ElectroTechnique/plinky_opensource/hw/plinkyblack_hwmidi_jacks/plinkyblack_hwmidi_jacks.kicad_sch

## KiCad design hw/plinkyblack_hwmidi_jacks/plinkyblack_hwmidi_jacks.kicad_sch (2024-01-15)

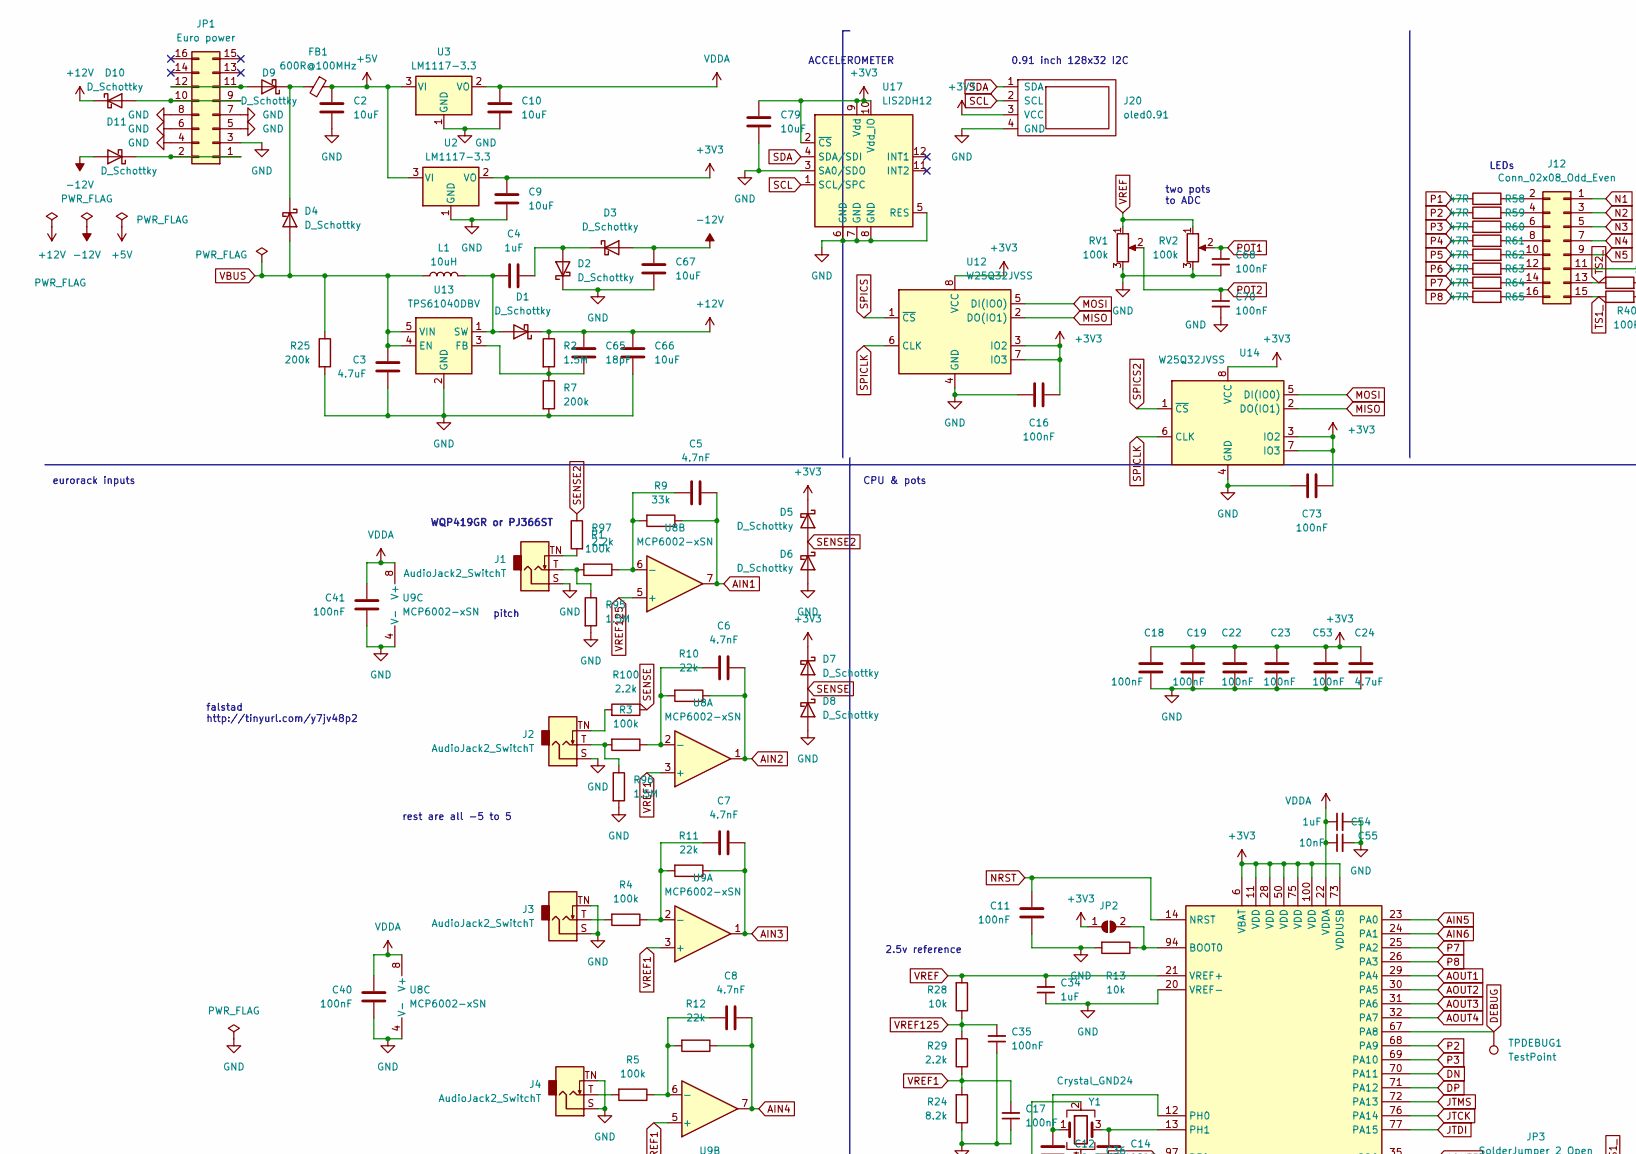
[picture p1: schematic plinkyblack_hwmidi_jacks.kicad_sch, part in row 1, column 1]

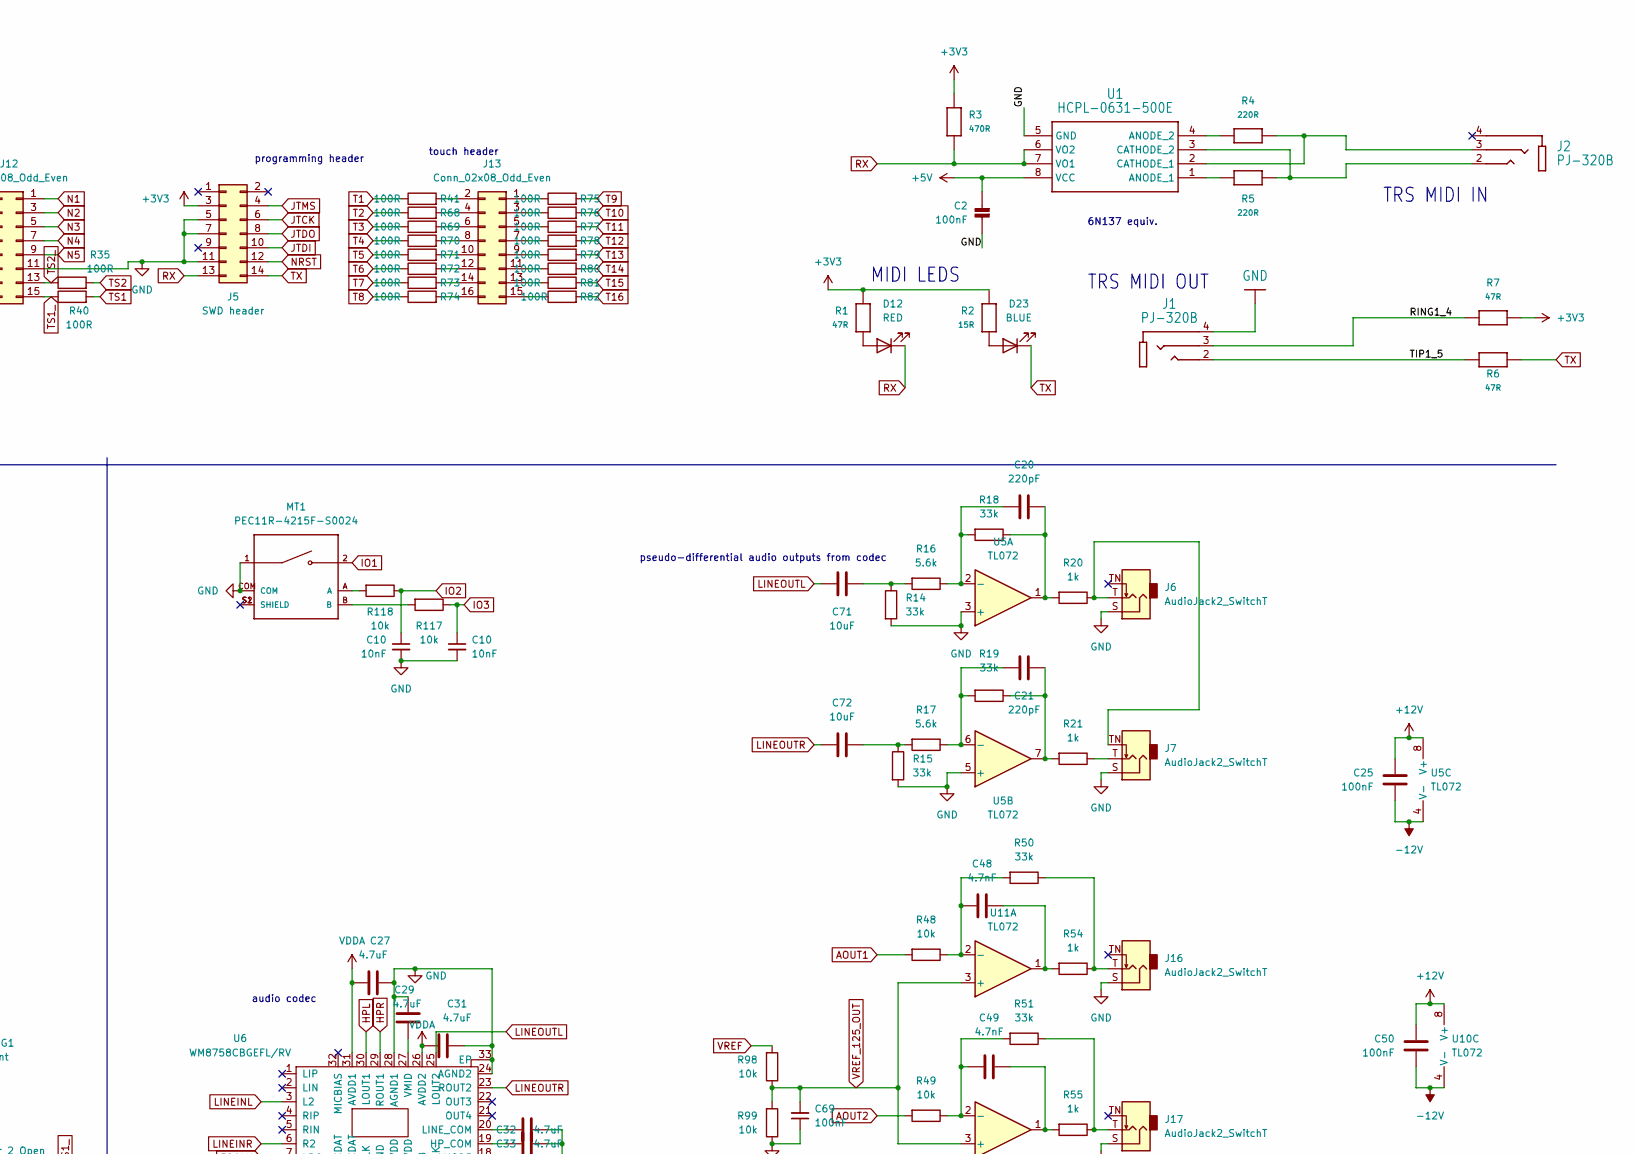
[picture p2: schematic plinkyblack_hwmidi_jacks.kicad_sch, part in row 1, column 2]

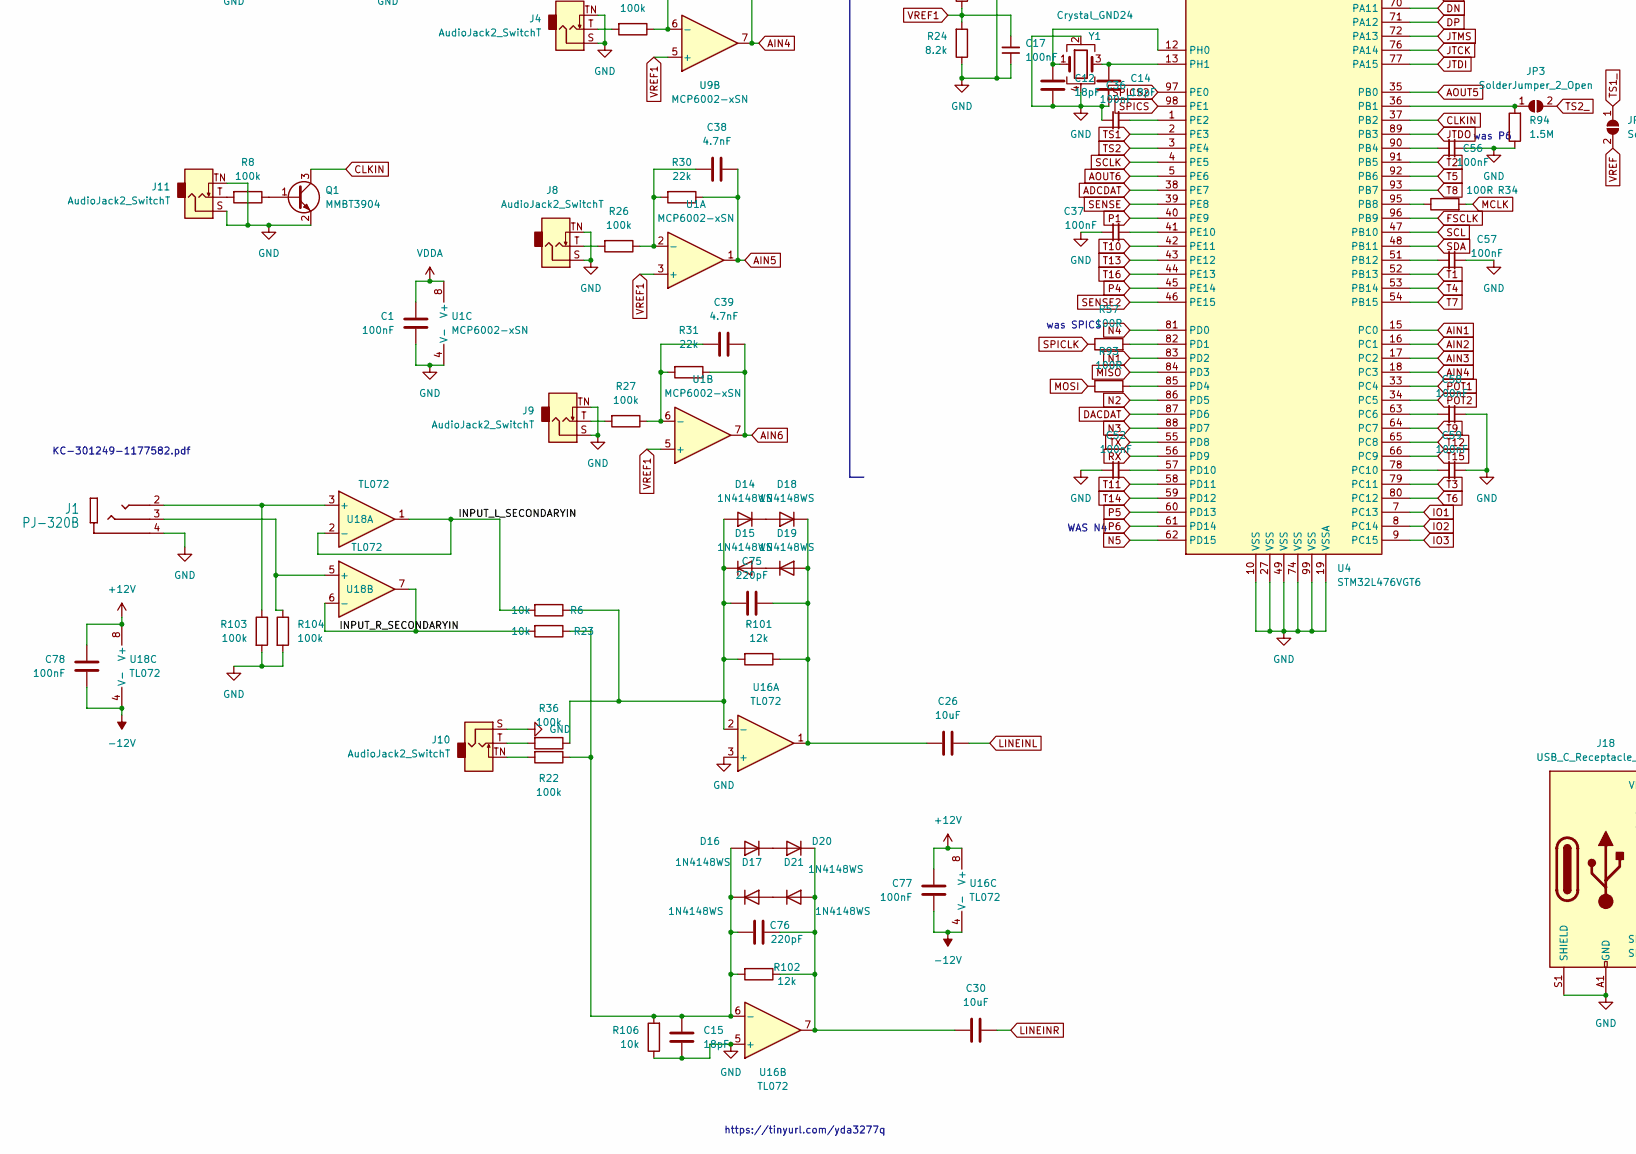
[picture p3: schematic plinkyblack_hwmidi_jacks.kicad_sch, part in row 2, column 1]

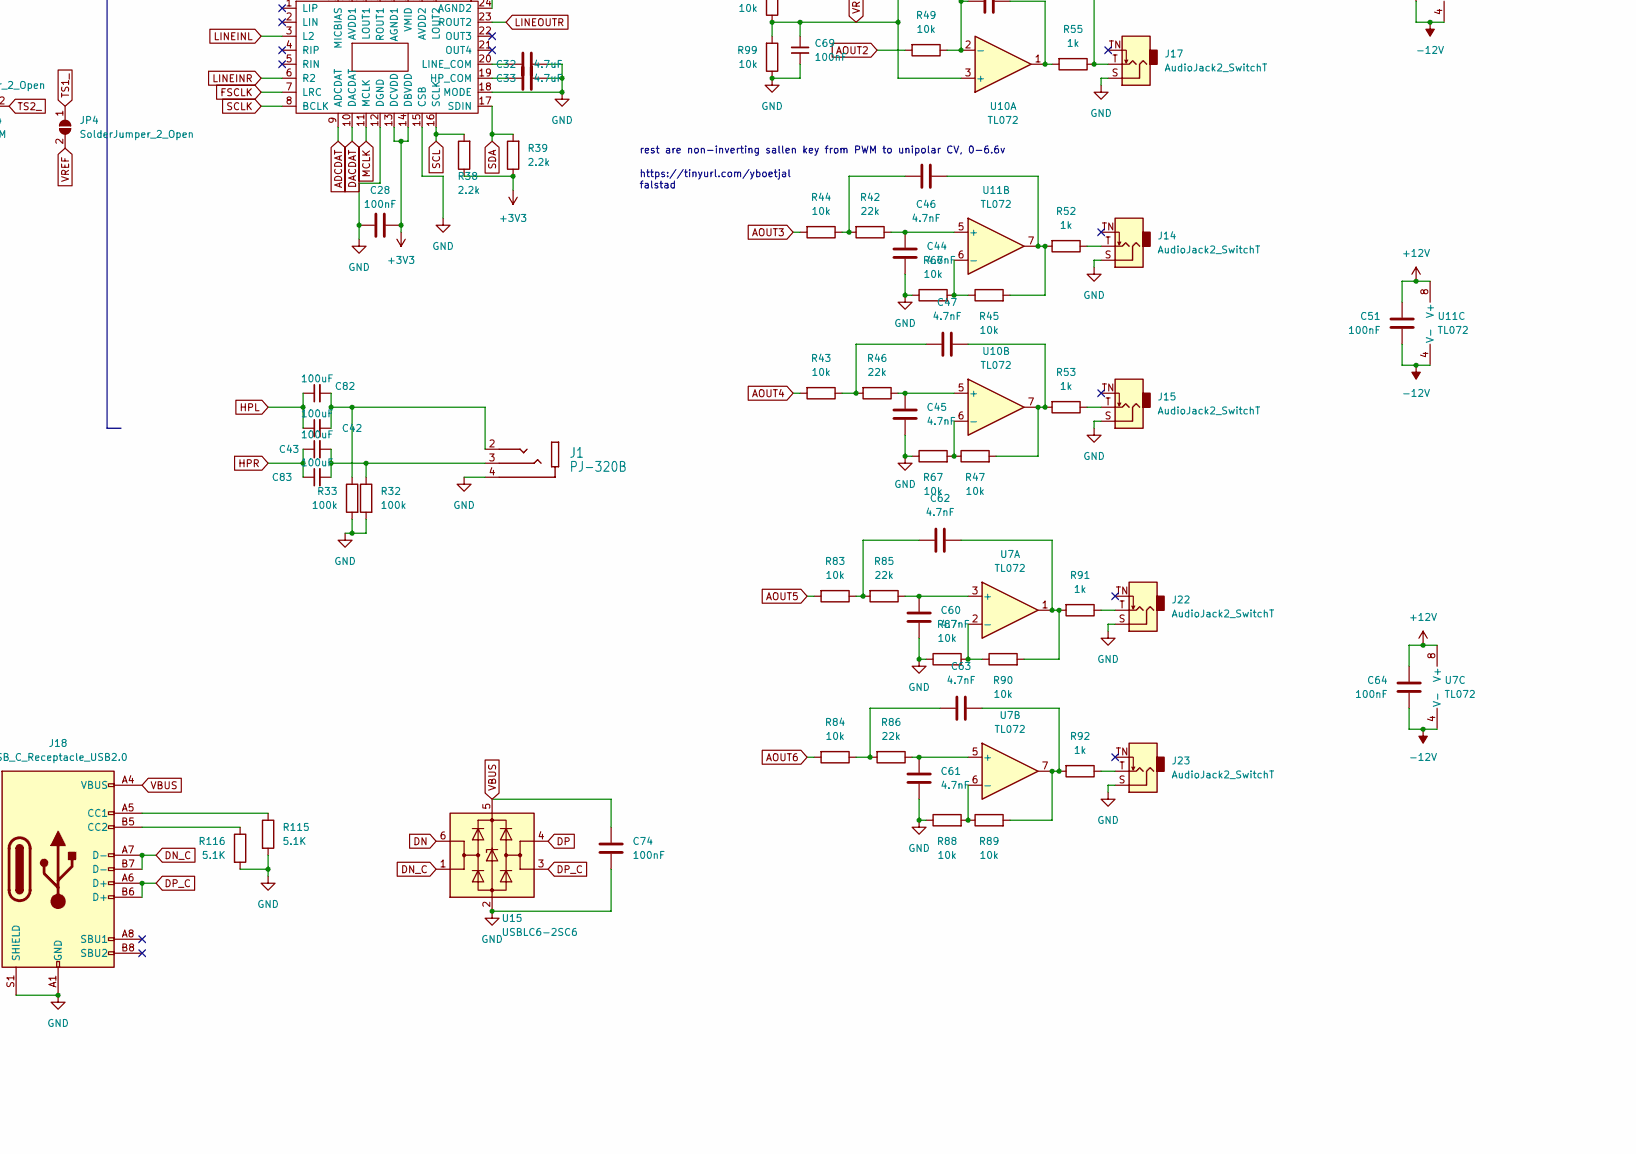
[picture p4: schematic plinkyblack_hwmidi_jacks.kicad_sch, part in row 2, column 2]

Parts:
C1, C11, C16, C17, C18, C19, C22, C23, C25, C28, C35, C36, C37, C40, C41, C50, C51, C52, C53, C56, C57, C58, C59, C64, C68, C69, C70, C73, C74, C77, C78: 100nF; C_0402_1005Metric; LCSC C307331
C2, C9, C10, C26, C30, C66, C67, C71, C72, C79: 10uF; C_0805_2012Metric; LCSC C15850
C3, C24, C27, C29, C31, C32, C33: 4.7uF; C_0603_1608Metric; LCSC C19666
C4, C34, C54: 1uF; C_0402_1005Metric; LCSC C52923
C5, C6, C7, C8, C38, C39, C44, C45, C46, C47, C48, C49, C60, C61, C62, C63: 4.7nF; C_0603_1608Metric; LCSC C53987
C12, C14, C15, C65: 18pF; C_0603_1608Metric; LCSC C1647
C20, C21, C75, C76: 220pF; C_0603_1608Metric; LCSC C1603
C42, C43, C82, C83: 100uF; C_1206_3216Metric; LCSC C15008
C55: 10nF; C_0603_1608Metric; LCSC C57112
D1, D2, D3, D4, D5, D6, D7, D8, D9, D10, D11: D_Schottky; D_SMA; LCSC C8678
D12: RED; LED_0603_1608Metric; LCSC C2286
D14, D15, D16, D17, D18, D19, D20, D21: 1N4148WS; D_SOD-323; LCSC C2128
D23: BLUE; LED_0603_1608Metric; LCSC C72041
FB1: 600R@100MHz; L_0805_2012Metric; LCSC C1017
J1, J2, J3, J4, J6, J7, J8, J9, J10, J11, J14, J15, J16, J17, J22, J23: AudioJack2_SwitchT; thonk_with_3d
J5: SWD header; PinHeader_2x07_P1.27mm_Vertical_SMD
J12, J13: Conn_02x08_Odd_Even; PinSocket_2x08_P2.54mm_Vertical
J18: USB_C_Receptacle_USB2.0; USB_C_Receptacle_HRO_TYPE-C-31-M-12; LCSC C165948
J20: oled0.91; oled091
JP1: Euro power; IDC-Header_2x08_P2.54mm_Horizontal
JP2, JP3, JP4: SolderJumper_2_Open; SolderJumper-2_P1.3mm_Open_Pad1.0x1.5mm
L1: 10uH; L_Murata_LQH55DN_5.7x5.0mm; LCSC C181721
MT1: PEC11R-4215F-S0024; pec11r_encoder
Q1: MMBT3904; SOT-23; LCSC C20526
R1, R3, R4, R5, R8, R26, R27, R32, R33, R103, R104: 100k; R_0402_1005Metric; LCSC C25741
R2, R94, R95, R96: 1.5M; R_0603_1608Metric; LCSC C4172
R6, R58, R59, R60, R61, R62, R63, R64, R65: 47R; R_0603_1608Metric; LCSC C23182
R7, R25: 200k; R_0603_1608Metric; LCSC C25811
R9, R14, R15, R18, R19, R50, R51: 33k; R_0402_1005Metric; LCSC C25779
R10, R11, R12, R30, R31, R42, R46, R85, R86: 22k; R_0402_1005Metric; LCSC C25768
R13, R23, R28, R43, R44, R45, R47, R48, R49, R66, R67, R83, R84, R87, R88, R89, R90, R98, R99, R106: 10k; R_0402_1005Metric; LCSC C25744
R16, R17: 5.6k; R_0603_1608Metric; LCSC C23189
R20, R21, R52, R53, R54, R55, R91, R92: 1k; R_0603_1608Metric; LCSC C21190
R22, R36: 100k; R_0805_2012Metric; LCSC C149504
R24: 8.2k; R_0603_1608Metric; LCSC C25981
R29, R38, R39, R97, R100: 2.2k; R_0603_1608Metric; LCSC C4190
R34, R35, R40, R41, R57, R68, R69, R70, R71, R72, R73, R74, R75, R76, R77, R78, R79, R80, R81, R82, R93: 100R; R_0402_1005Metric; LCSC C25076
R101, R102: 12k; R_0402_1005Metric; LCSC C25752
R115, R116: 5.1K; R_0402_1005Metric; LCSC C25905
R117, R118: 10k; R_0603_1608Metric; LCSC C25804
RV1, RV2: 100k; pot3d
TPDEBUG1: TestPoint; TestPoint_Pad_D1.0mm
U1, U8, U9: MCP6002-xSN; SOIC-8_3.9x4.9mm_P1.27mm; LCSC C7377
U2, U3: LM1117-3.3; SOT-223-3_TabPin2; LCSC C6186
U4: STM32L476VGT6; LQFP-100_14x14mm_P0.5mm; LCSC C83181
U5, U7, U10, U11, U16, U18: TL072; SOIC-8_3.9x4.9mm_P1.27mm; LCSC C6961
U6: WM8758CBGEFL/RV; QFN-32-1EP_5x5mm_P0.5mm_EP3.45x3.45mm; LCSC C323840
U12, U14: W25Q32JVSS; SOIC-8_5.275x5.275mm_P1.27mm; LCSC C97521
U13: TPS61040DBV; SOT-23-5; LCSC C7722
U15: USBLC6-2SC6; SOT-23-6; LCSC C2687116
U17: LIS2DH12; LGA-12_2x2mm_P0.5mm; LCSC C110926
Y1: Crystal_GND24; Crystal_SMD_Abracon_ABM8G-4Pin_3.2x2.5mm; LCSC C13738

Connections:
+3V3: C9.1, C16.1, C18.1, C19.1, C22.1, C23.1, C24.1, C28.2, C53.1, C73.1, C79.1, D5.1 (K), D7.1 (K), J5.3, J20.3 (VCC), JP2.1 (A), R1.2, R2.2, R3.2, R7.2, R38.1, R39.1, U2.2 (VO), U4.6 (VBAT), U4.11 (VDD), U4.28 (VDD), U4.50 (VDD), U4.73 (VDDUSB), U4.75 (VDD), U4.100 (VDD), U6.13 (DCVDD), U6.14 (DBVDD), U12.3 (IO2), U12.7 (IO3), U12.8 (VCC), U14.3 (IO2), U14.7 (IO3), U14.8 (VCC), U17.2 (~CS), U17.9 (Vdd), U17.10 (Vdd_IO)
+5V: C2.1, C2.2, FB1.1, U1.8 (VCC), U2.3 (VI), U3.3 (VI)
+12V: C25.2, C50.2, C51.2, C64.2, C65.2, C66.1, C77.2, C78.2, D1.1 (K), D10.1 (K), R2.1, U5.8 (V+), U7.8 (V+), U10.8 (V+), U11.8 (V+), U16.8 (V+), U18.8 (V+)
-12V: C25.1, C50.1, C51.1, C64.1, C67.1, C77.1, C78.1, D3.2 (A), D11.2 (A), U5.4 (V-), U7.4 (V-), U10.4 (V-), U11.4 (V-), U16.4 (V-), U18.4 (V-)
ADCDAT: U4.38 (PE7), U6.9 (ADCDAT)
AIN1: C5.1, R9.1, U4.15 (PC0), U8.7
AIN2: C6.1, R10.1, U4.16 (PC1), U8.1
AIN3: C7.1, R11.1, U4.17 (PC2), U9.1
AIN4: C8.1, R12.1, U4.18 (PC3), U9.7
AIN5: C38.1, R30.1, U1.1 (ANODE_1), U4.23 (PA0)
AIN6: C39.1, R31.1, U1.7 (VO1), U4.24 (PA1)
AOUT1: R48.2, U4.29 (PA4)
AOUT2: R49.2, U4.30 (PA5)
AOUT3: R44.2, U4.31 (PA6)
AOUT4: R43.2, U4.32 (PA7)
AOUT5: R83.2, U4.35 (PB0)
AOUT6: R84.2, U4.5 (PE6)
CLKIN: Q1.3 (C), U4.37 (PB2)
DACDAT: U4.87 (PD6), U6.10 (DACDAT)
DEBUG: TPDEBUG1.1, U4.67 (PA8)
DN: U4.70 (PA11), U15.6 (I/O1)
DN_C: J18.A7 (D-), J18.B7 (D-), U15.1 (I/O1)
DP: U4.71 (PA12), U15.4 (I/O2)
DP_C: J18.A6 (D+), J18.B6 (D+), U15.3 (I/O2)
FSCLK: U4.96 (PB9), U6.7 (LRC)
GND: C1.1, C2.1, C2.2, C3.2, C9.2, C10.2, C11.2, C12.2, C14.2, C15.1, C16.2, C17.1, C18.2, C19.2, C22.2, C23.2, C24.2, C27.2, C28.1, C29.2, C31.1, C32.2, C33.2, C34.1, C35.1, C36.1, C37.1, C40.1, C41.1, C44.1, C45.1, C52.1, C53.2, C54.2, C55.2, C56.1, C57.1, C58.1, C59.1, C60.1, C61.1, C66.2, C67.2, C68.2, C69.1, C70.2, C73.2, C74.1, C79.2, D2.1 (K), D6.2 (A), D8.2 (A), J1.4 (SLEEVE), J1.S, J2.S, J3.S, J3.TN, J4.S, J4.TN, J5.5, J5.7, J5.11, J6.S, J7.S, J8.S, J8.TN, J9.S, J9.TN, J10.S, J11.S, J11.TN, J12.11, J14.S, J15.S, J16.S, J17.S, J18.A1 (GND), J18.A12 (GND), J18.B1 (GND), J18.B12 (GND), J18.S1 (SHIELD), J20.4 (GND), J22.S, J23.S, JP1.3, JP1.4, JP1.5, JP1.6, JP1.7, JP1.8, MT1.1, MT1.COM, Q1.2 (E), R7.2, R13.2, R14.2, R15.2, R24.1, R25.2, R32.2, R33.2, R66.1, R67.1, R87.1, R88.1, R94.1, R95.2, R96.2, R99.1, R103.2, R104.2, R106.1, R115.2, R116.2, RV1.3, RV2.3, U1.4 (ANODE_2), U1.5 (GND), U2.1 (GND), U3.1 (GND), U4.10 (VSS), U4.19 (VSSA), U4.20 (VREF-), U4.27 (VSS), U4.49 (VSS), U4.74 (VSS), U4.99 (VSS), U5.3 (+), U5.5 (+), U6.12 (DGND), U6.15 (CSB), U6.18 (MODE), U6.24 (AGND2), U6.28 (AGND1), U6.33 (EP), U8.4 (V-), U9.4 (V-), U12.4 (GND), U13.2 (GND), U14.4 (GND), U15.2 (GND), U16.3 (+), U16.5 (+), U17.3 (SA0/SDO), U17.5 (RES), U17.6 (GND), U17.7 (GND), U17.8 (GND), Y1.2, Y1.4
HPL: C42.1, C82.1, U6.30 (LOUT1)
HPR: C43.1, C83.1, U6.29 (ROUT1)
INPUT_L_SECONDARYIN: R6.2, U18.1, U18.2 (-)
INPUT_R_SECONDARYIN: R23.2, U18.6 (-), U18.7
IO1: MT1.2, U4.7 (PC13)
IO2: C10.1, R118.1, U4.8 (PC14)
IO3: C10.1, R117.1, U4.9 (PC15)
JTCK: J5.6, U4.76 (PA14)
JTDI: J5.10, U4.77 (PA15)
JTDO: J5.8, U4.89 (PB3)
JTMS: J5.4, U4.72 (PA13)
LINEINL: C26.1, U6.3 (L2)
LINEINR: C30.1, U6.6 (R2)
LINEOUTL: C71.2, U6.25 (LOUT2)
LINEOUTR: C72.2, U6.23 (ROUT2)
MCLK: R34.2, U6.11 (MCLK)
MISO: U4.84 (PD3), U12.2 (DO(IO1)), U14.2 (DO(IO1))
MOSI: R93.1, U12.5 (DI(IO0)), U14.5 (DI(IO0))
N1: J12.1, U4.83 (PD2)
N2: J12.3, U4.86 (PD5)
N3: J12.5, U4.88 (PD7)
N4: J12.7, U4.81 (PD0)
N5: J12.9, U4.62 (PD15)
NRST: C11.1, J5.12, U4.14 (NRST)
unnamed: C4.1, D2.2 (A), D3.1 (K)
unnamed: C4.2, D1.2 (A), L1.2, U13.1 (SW)
unnamed: C5.2, R1.1, R9.2, U8.6 (-)
unnamed: C6.2, R3.1, R10.2, U8.2 (-)
unnamed: C7.2, R4.1, R11.2, U9.2 (-)
unnamed: C8.2, R5.1, R12.2, U9.6 (-)
unnamed: C12.1, U4.12 (PH0), Y1.1
unnamed: C14.1, U4.13 (PH1), Y1.3
unnamed: C15.2, C76.1, D16.2 (A), D17.1 (K), R22.1, R23.1, R102.2, R106.2, U16.6 (-)
unnamed: C20.1, R18.1, R20.2, U5.1
unnamed: C20.2, R16.1, R18.2, U5.2 (-)
unnamed: C21.1, R19.1, R21.2, U5.7
unnamed: C21.2, R17.1, R19.2, U5.6 (-)
unnamed: C26.2, C75.2, D18.1 (K), D19.2 (A), R101.1, U16.1
unnamed: C29.1, U6.27 (VMID)
unnamed: C30.2, C76.2, D20.1 (K), D21.2 (A), R102.1, U16.7
unnamed: C32.1, U6.20 (LINE_COM)
unnamed: C33.1, U6.19 (HP_COM)
unnamed: C36.2, U4.1 (PE2)
unnamed: C37.2, U4.41 (PE10)
unnamed: C38.2, R26.1, R30.2, U1.2 (CATHODE_1)
unnamed: C39.2, R27.1, R31.2, U1.6 (VO2)
unnamed: C42.2, C82.2, J1.2 (TIP), R33.1
unnamed: C43.2, C83.2, J1.3 (RING), R32.1
unnamed: C44.2, R42.1, U11.5 (+)
unnamed: C45.2, R46.1, U10.5 (+)
unnamed: C46.1, R42.2, R44.1
unnamed: C46.2, R45.2, R52.2, U11.7
unnamed: C47.1, R43.1, R46.2
unnamed: C47.2, R47.2, R53.2, U10.7
unnamed: C48.1, R54.2, U11.1
unnamed: C48.2, R48.1, R50.2, U11.2 (-)
unnamed: C49.1, R55.2, U10.1
unnamed: C49.2, R49.1, R51.2, U10.2 (-)
unnamed: C52.2, U4.57 (PD10)
unnamed: C56.2, U4.90 (PB4)
unnamed: C57.2, U4.51 (PB12)
unnamed: C58.2, U4.63 (PC6)
unnamed: C59.2, U4.78 (PC10)
unnamed: C60.2, R85.1, U7.3 (+)
unnamed: C61.2, R86.1, U7.5 (+)
unnamed: C62.1, R83.1, R85.2
unnamed: C62.2, R90.2, R91.2, U7.1
unnamed: C63.1, R84.1, R86.2
unnamed: C63.2, R89.2, R92.2, U7.7
unnamed: C65.1, R2.2, R7.1, U13.3 (FB)
unnamed: C71.1, R14.1, R16.2
unnamed: C72.1, R15.1, R17.2
unnamed: C75.1, D14.2 (A), D15.1 (K), R6.1, R36.1, R101.2, U16.2 (-)
unnamed: D4.1 (K), D9.1 (K), FB1.2
unnamed: D9.2 (A), JP1.11, JP1.12
unnamed: D10.2 (A), JP1.9, JP1.10
unnamed: D11.1 (K), JP1.1, JP1.2
unnamed: D12.2 (A), R1.1
unnamed: D14.1 (K), D18.2 (A)
unnamed: D15.2 (A), D19.1 (K)
unnamed: D16.1 (K), D20.2 (A)
unnamed: D17.2 (A), D21.1 (K)
unnamed: D23.2 (A), R2.1
unnamed: J1.2 (TIP), R103.1, U18.3 (+)
unnamed: J1.3 (RING), R104.1, U18.5 (+)
unnamed: J1.T, R1.2, R95.1
unnamed: J1.TN, R97.2
unnamed: J2.2 (TIP), R5.1, U1.3 (CATHODE_2)
unnamed: J2.3 (RING), R4.1, U1.2 (CATHODE_1)
unnamed: J2.T, R3.2, R96.1
unnamed: J2.TN, R100.2
unnamed: J3.T, R4.2
unnamed: J4.T, R5.2
unnamed: J6.T, J7.TN, R20.1
unnamed: J7.T, R21.1
unnamed: J8.T, R26.2
unnamed: J9.T, R27.2
unnamed: J10.T, R36.2
unnamed: J10.TN, R22.2
unnamed: J11.T, R8.2
unnamed: J12.2, R58.2
unnamed: J12.4, R59.2
unnamed: J12.6, R60.2
unnamed: J12.8, R61.2
unnamed: J12.10, R62.2
unnamed: J12.12, R63.2
unnamed: J12.14, R64.2
unnamed: J12.16, R65.2
unnamed: J13.1, R75.1
unnamed: J13.2, R41.2
unnamed: J13.3, R76.1
unnamed: J13.4, R68.2
unnamed: J13.5, R77.1
unnamed: J13.6, R69.2
unnamed: J13.7, R78.1
unnamed: J13.8, R70.2
unnamed: J13.9, R79.1
unnamed: J13.10, R71.2
unnamed: J13.11, R80.1
unnamed: J13.12, R72.2
unnamed: J13.13, R81.1
unnamed: J13.14, R73.2
unnamed: J13.15, R82.1
unnamed: J13.16, R74.2
unnamed: J14.T, R52.1
unnamed: J15.T, R53.1
unnamed: J16.T, R50.1, R54.1
unnamed: J17.T, R51.1, R55.1
unnamed: J18.A5 (CC1), R115.1
unnamed: J18.B5 (CC2), R116.1
unnamed: J22.T, R91.1
unnamed: J23.T, R92.1
unnamed: JP2.2 (B), R13.1, U4.94 (BOOT0)
unnamed: JP3.1 (A), R94.2, U4.36 (PB1)
unnamed: MT1.A, R118.2
unnamed: MT1.B, R117.2
unnamed: MT1.S1 (SHIELD), MT1.S2 (SHIELD)
unnamed: Q1.1 (B), R8.1
unnamed: R4.2, U1.4 (ANODE_2)
unnamed: R5.2, U1.1 (ANODE_1)
unnamed: R34.1, U4.95 (PB8)
unnamed: R45.1, R66.2, U11.6 (-)
unnamed: R47.1, R67.2, U10.6 (-)
unnamed: R57.2, U4.82 (PD1)
unnamed: R87.2, R90.1, U7.2 (-)
unnamed: R88.2, R89.1, U7.6 (-)
unnamed: R93.2, U4.85 (PD4)
P1: R58.1, U4.40 (PE9)
P2: R59.1, U4.68 (PA9)
P3: R60.1, U4.69 (PA10)
P4: R61.1, U4.45 (PE14)
P5: R62.1, U4.60 (PD13)
P6: R63.1, U4.61 (PD14)
P7: R64.1, U4.25 (PA2)
P8: R65.1, U4.26 (PA3)
POT1: C68.1, RV2.2, U4.33 (PC4)
POT2: C70.1, RV1.2, U4.34 (PC5)
RING1_4: J1.3 (RING), R7.1
RX: D12.1 (K), J5.13, R3.1, U1.6 (VO2), U1.7 (VO1), U4.56 (PD9)
SCL: J20.2 (SCL), R38.2, U4.47 (PB10), U6.16 (SCLK), U17.1 (SCL/SPC)
SCLK: U4.4 (PE5), U6.8 (BCLK)
SDA: J20.1 (SDA), R39.2, U4.48 (PB11), U6.17 (SDIN), U17.4 (SDA/SDI)
SENSE: D7.2 (A), D8.1 (K), R100.1, U4.39 (PE8)
SENSE2: D5.2 (A), D6.1 (K), R97.1, U4.46 (PE15)
SPICLK: R57.1, U12.6 (CLK), U14.6 (CLK)
SPICS: U4.98 (PE1), U12.1 (~CS)
SPICS2: U4.97 (PE0), U14.1 (~CS)
T1: R41.1, U4.52 (PB13)
T2: R68.1, U4.91 (PB5)
T3: R69.1, U4.79 (PC11)
T4: R70.1, U4.53 (PB14)
T5: R71.1, U4.92 (PB6)
T6: R72.1, U4.80 (PC12)
T7: R73.1, U4.54 (PB15)
T8: R74.1, U4.93 (PB7)
T9: R75.2, U4.64 (PC7)
T10: R76.2, U4.42 (PE11)
T11: R77.2, U4.58 (PD11)
T12: R78.2, U4.65 (PC8)
T13: R79.2, U4.43 (PE12)
T14: R80.2, U4.59 (PD12)
T15: R81.2, U4.66 (PC9)
T16: R82.2, U4.44 (PE13)
TIP1_5: J1.2 (TIP), R6.1
TS1: R40.2, U4.2 (PE3)
TS1_: J12.15, JP4.1 (A), R40.1
TS2: R35.2, U4.3 (PE4)
TS2_: J12.13, JP3.2 (B), R35.1
TX: D23.1 (K), J5.14, R6.2, U4.55 (PD8)
VBUS: C3.1, C74.2, D4.2 (A), J18.A4 (VBUS), J18.A9 (VBUS), J18.B4 (VBUS), J18.B9 (VBUS), L1.1, R25.1, U13.4 (EN), U13.5 (VIN), U15.5 (VBUS)
VDDA: C1.2, C10.1, C27.1, C31.2, C40.2, C41.2, C54.1, C55.1, U1.8 (VCC), U3.2 (VO), U4.22 (VDDA), U6.26 (AVDD2), U6.31 (AVDD1), U8.8 (V+), U9.8 (V+)
VREF: C34.2, JP4.2 (B), R28.2, R98.2, RV1.1, RV2.1, U4.21 (VREF+)
VREF1: C17.2, R24.2, R29.1, U1.3 (CATHODE_2), U1.5 (GND), U8.3 (+), U9.3 (+), U9.5 (+)
VREF125: C35.2, R28.1, R29.2, U8.5 (+)
VREF_125_OUT: C69.2, R98.1, R99.2, U10.3 (+), U11.3 (+)

Notes on the sheet:
MIDI LEDS
was P6
eurorack inputs
touch header
KC-301249-1177582.pdf
2.5v reference
was SPICS
https://tinyurl.com/yda3277q
falstad http://tinyurl.com/y7jv48p2
TRS MIDI OUT
CPU & pots
pitch
WQP419GR or PJ366ST
audio codec
ACCELEROMETER
https://tinyurl.com/yboetjal falstad
programming header
LEDs
0.91 inch 128x32 I2C
6N137 equiv.
WAS N4
rest are non-inverting sallen key from PWM to unipolar CV, 0-6.6v
two pots to ADC
pseudo-differential audio outputs from codec
rest are all -5 to 5
TRS MIDI IN
